Red9/hellenic-boards/documentation/gamma/gamma_gerber/gamma_stencil_thickness.png

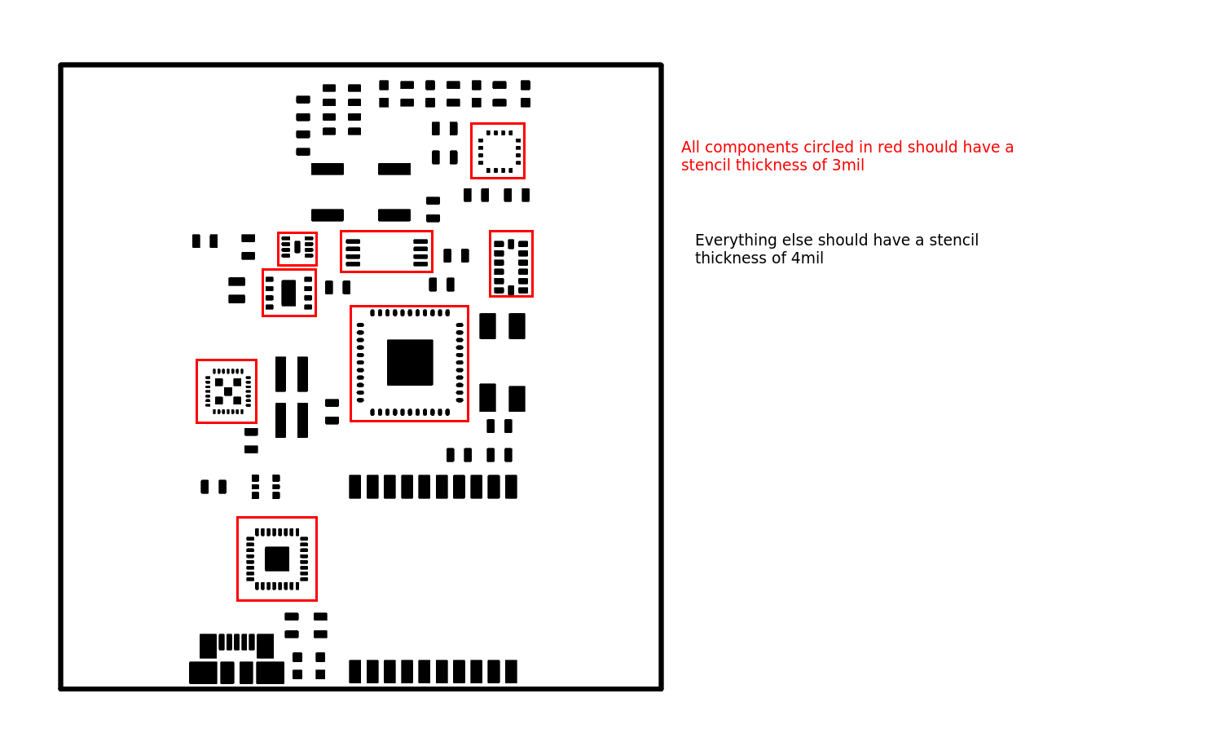
documentation/gamma/gamma_gerber/gamma_stencil_thickness.png
