Red9/hellenic-boards/documentation/gamma/scad.pdf

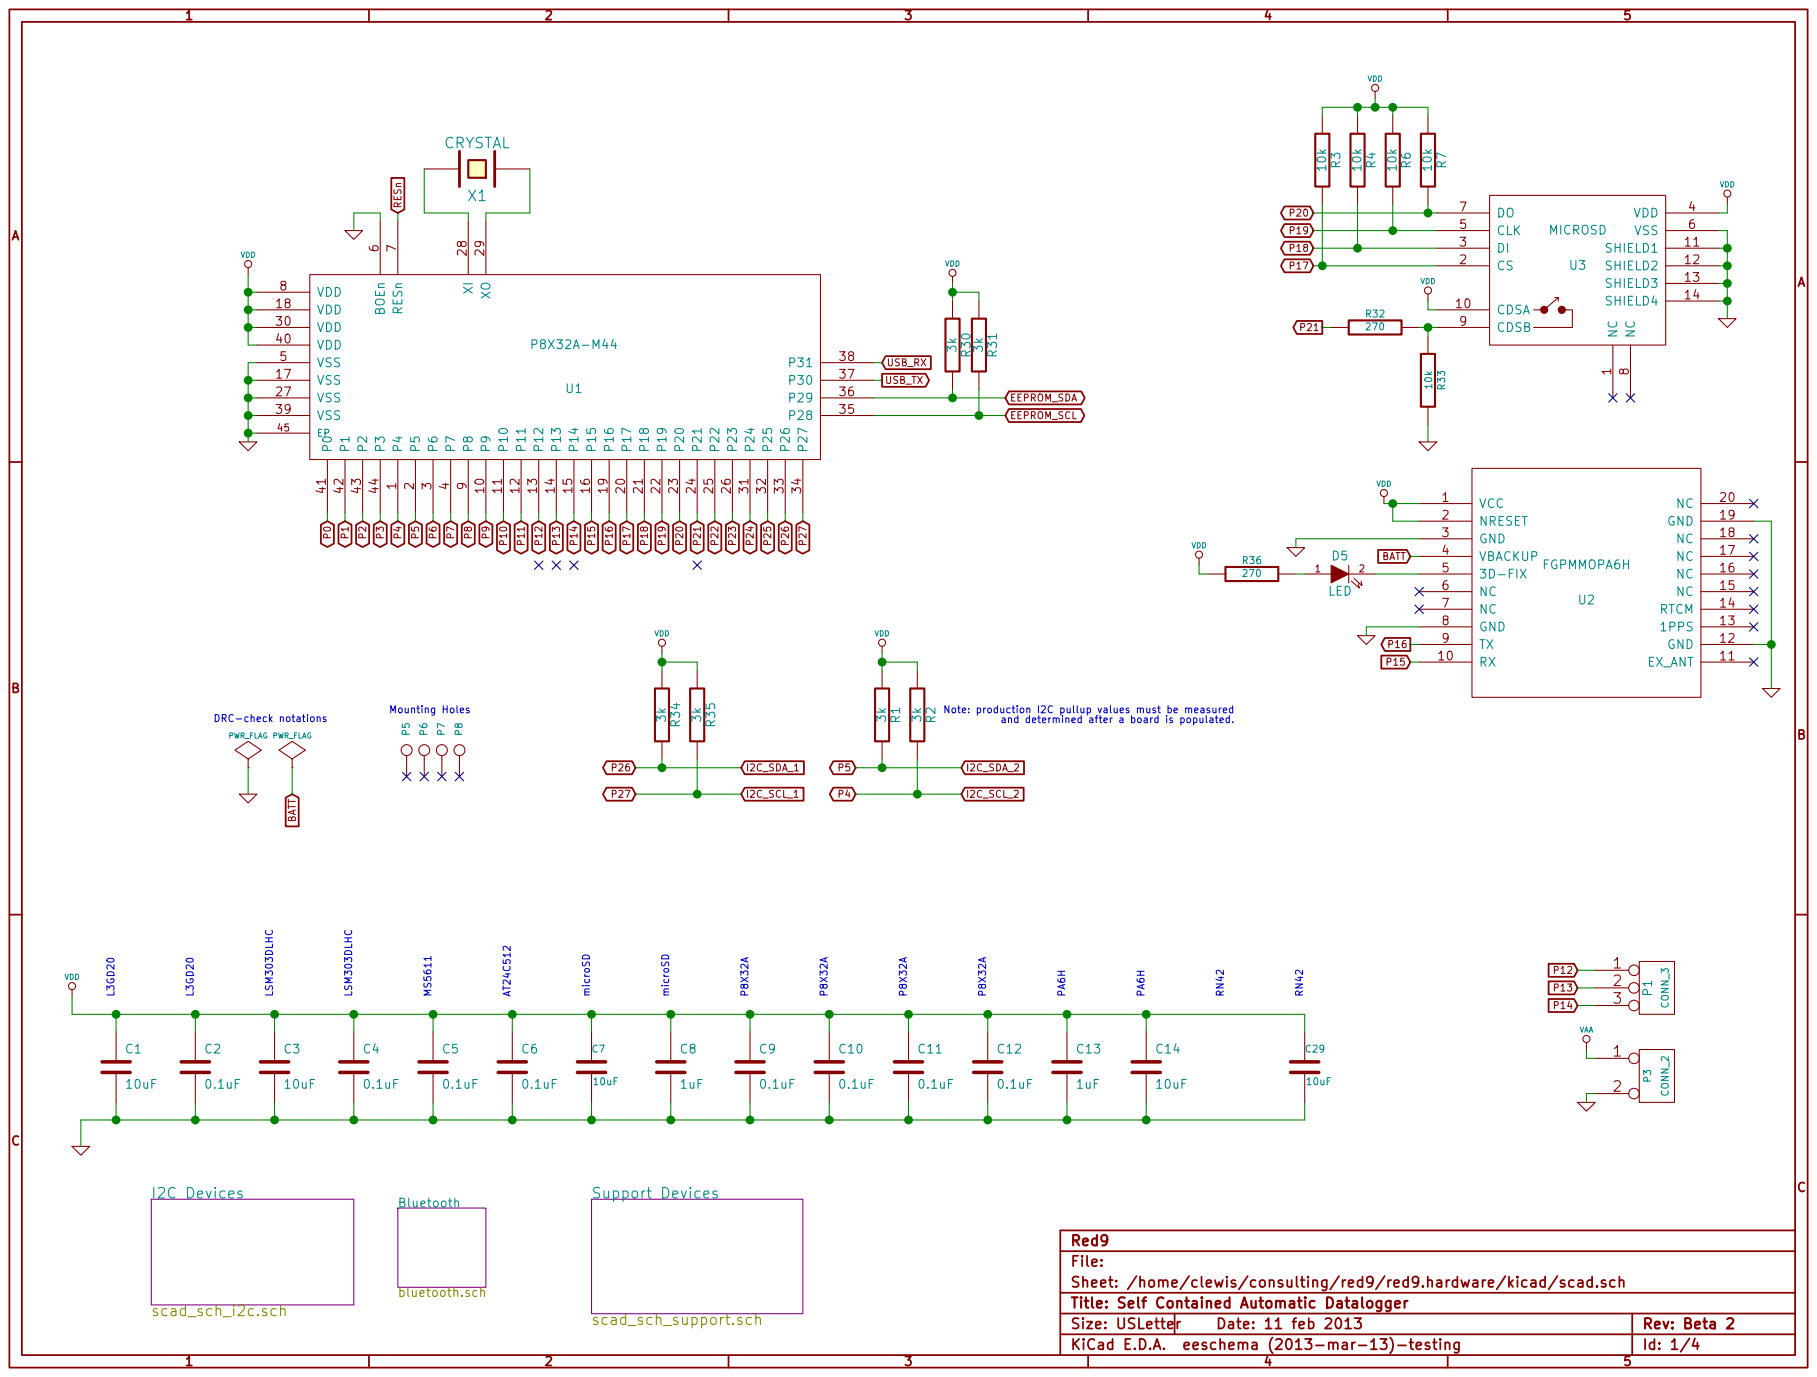
[picture p7: page 1]

1 CS 2 DI 3 VDD 4 CLK 5 VSS 6 DO 7 NC

Note: production I2C pullup values must be measured

C Red9 Sheet: /home/clewis/consulting/red9/red9.hardware/kicad/scad.sch File: Title: Self Contained Automatic Datalogger

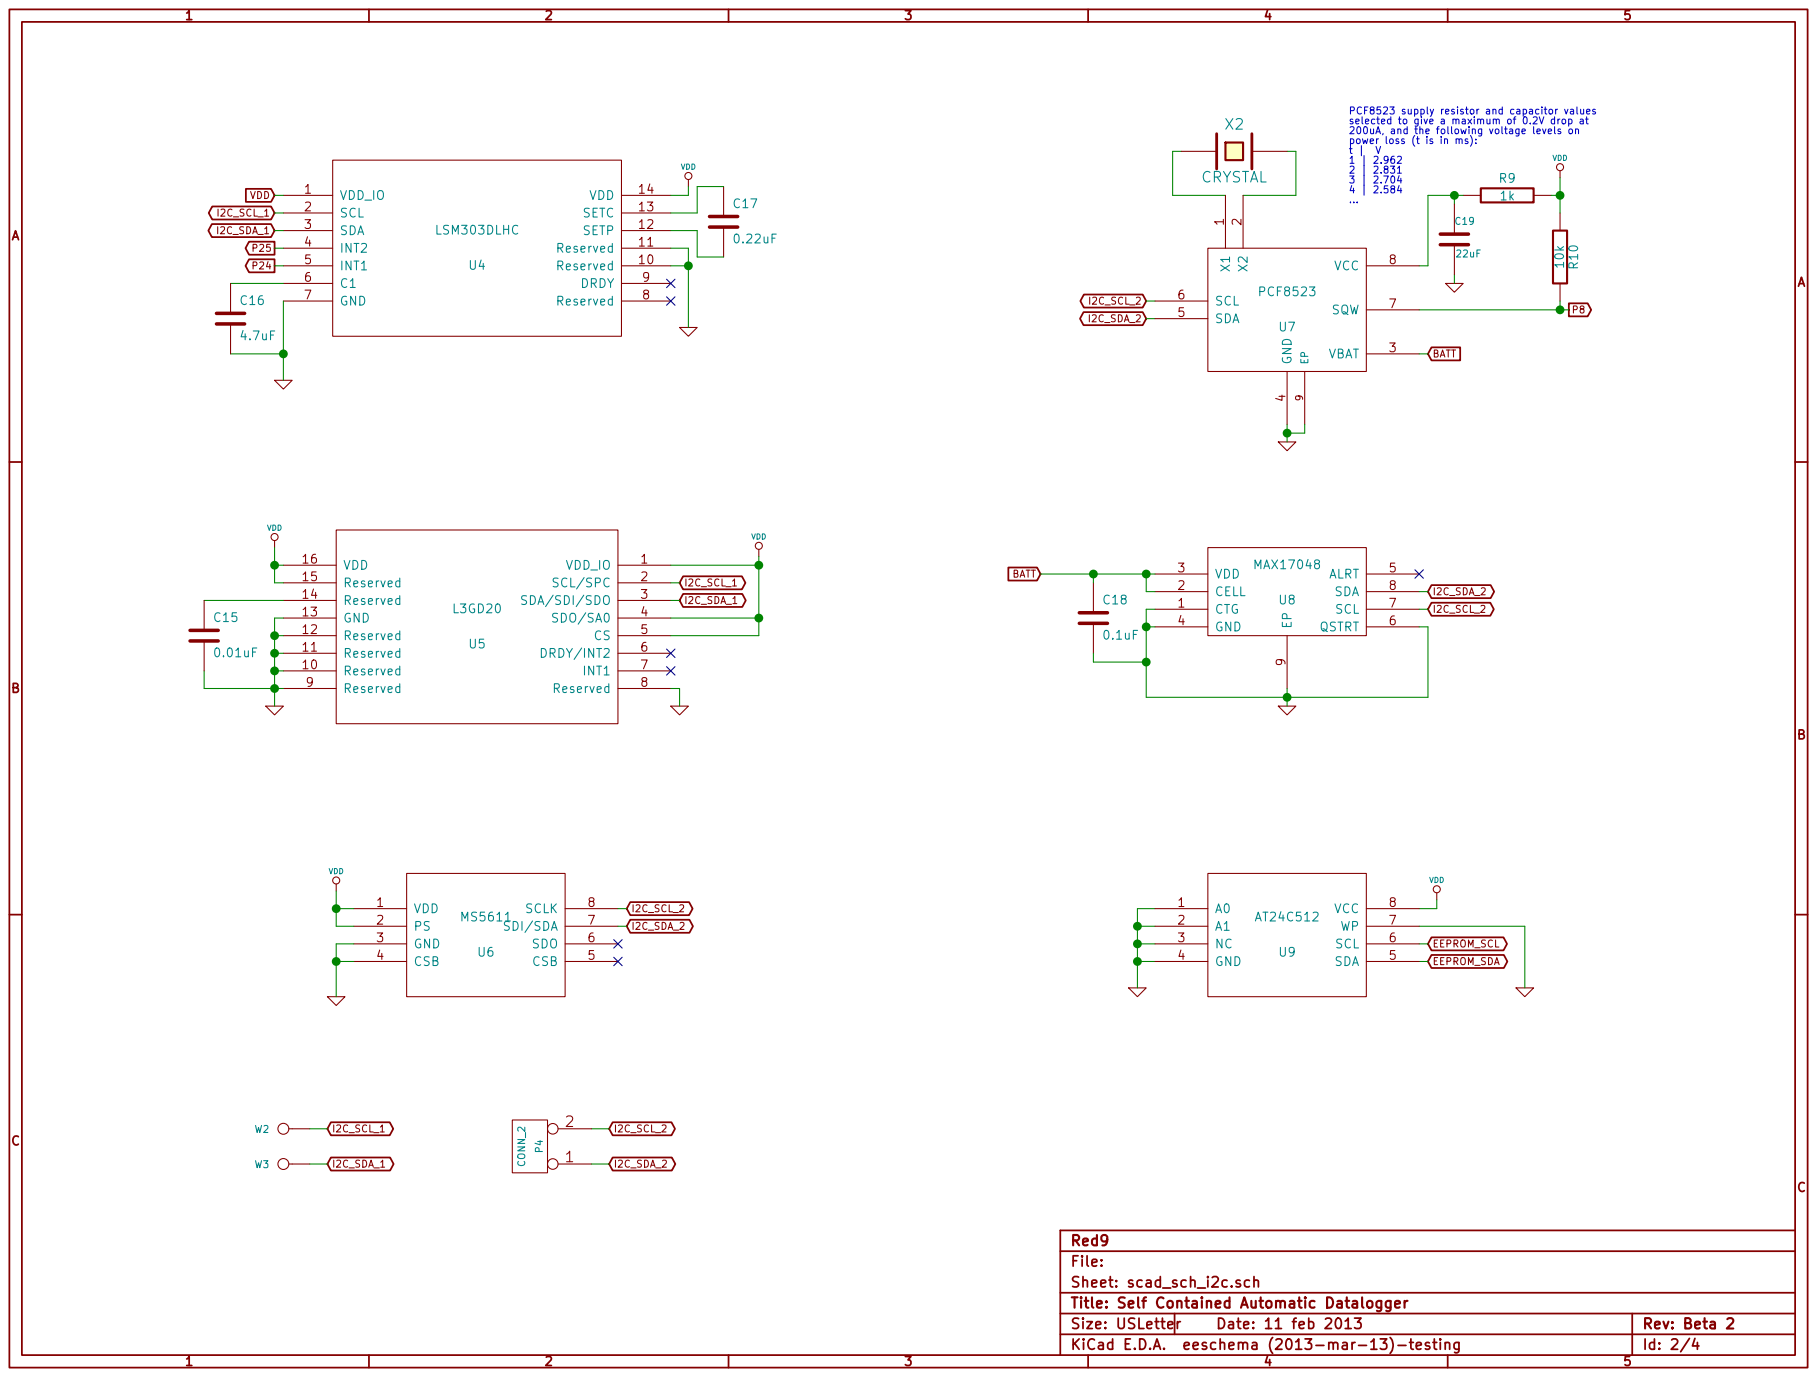
[picture p8: page 2]

1k PCF8523 supply resistor and capacitor values
selected to give a maximum of 0.2V drop at 200uA, and the following voltage levels on
power loss (t is in ms):

4 SDA 5 SCL 6 SQW 7 VCC 8 EP

C Red9 Sheet: scad_sch_i2c.sch File: Title: Self Contained Automatic Datalogger

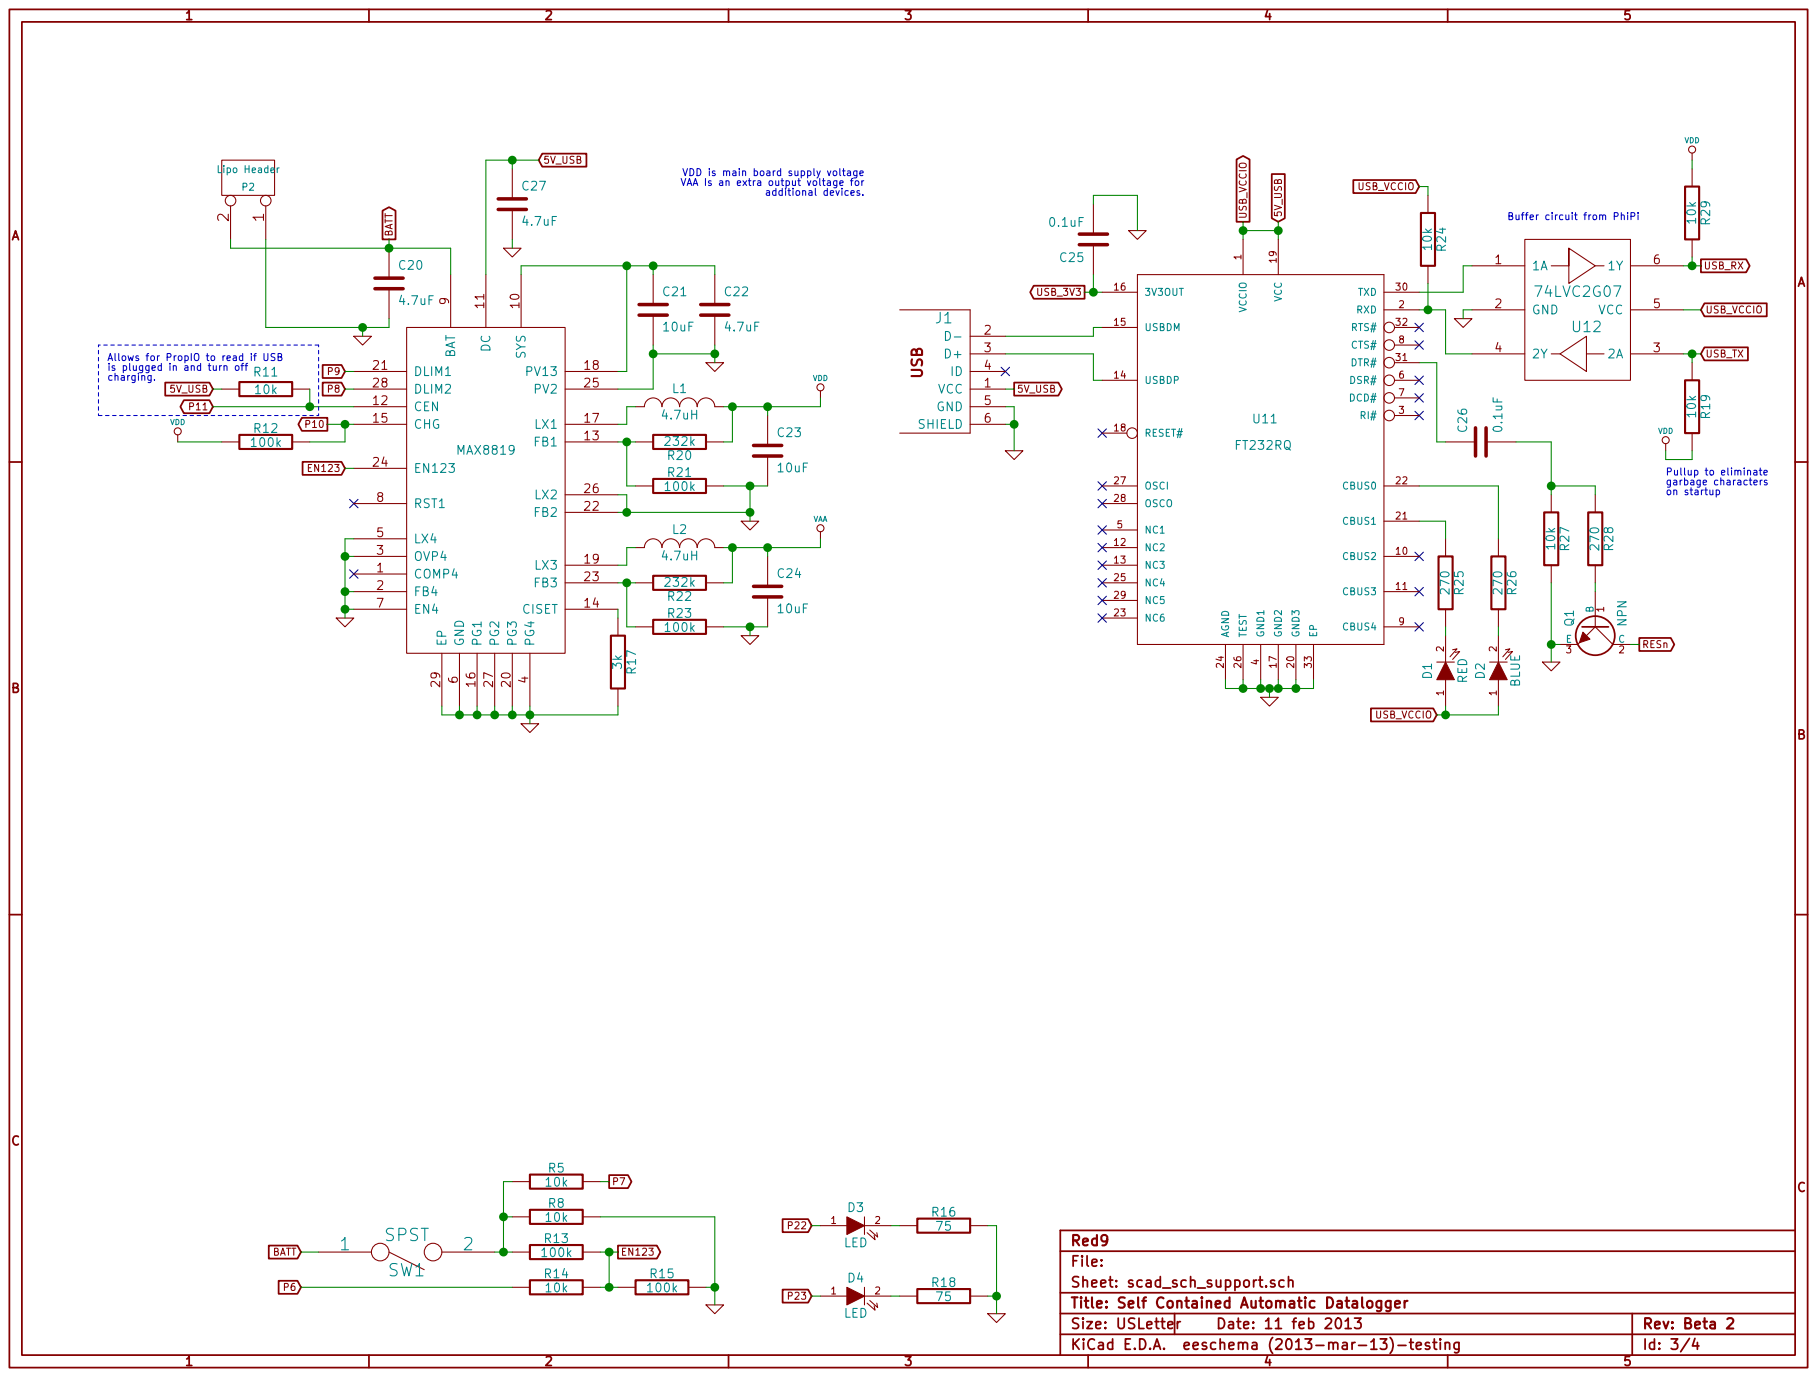
[picture p9: page 3]

VDD is main board supply voltage VAA Is an extra output voltage for

Buffer circuit from PhiPi

4 NC1 5 DSR# 6 DCD# 7 CTS# 8 CBUS4 9 CBUS2 10 GND3 20 TXD 30 CBUS3 11 CBUS1 21 DTR# 31 NC2 12 CBUS0 22 RTS# 32 NC3 13 NC6 23 EP 33 USBDP 14 AGND 24 USBDM 15 NC4 25

9 SYS 10 PG3 20 DC 11 DLIM1 21 CEN 12 FB2 22 FB1 13 FB3 23 CISET 14 EN123 24 CHG 15 PV2 25 PG1 16

VDD Allows for PropIO to read if USB

C Red9 Sheet: scad_sch_support.sch File: Title: Self Contained Automatic Datalogger

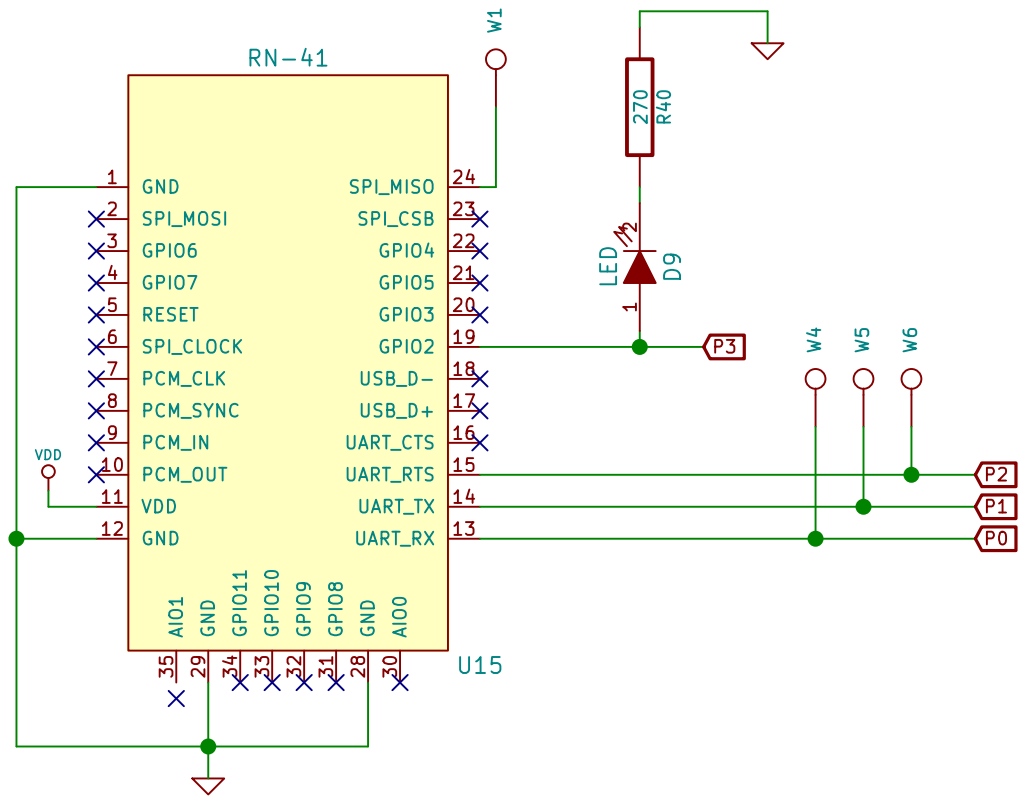
[picture p10: page 4]

C Sheet: bluetooth.sch File: Title:
