Red9/hellenic-boards/documentation/beta2/scad_beta2.pdf

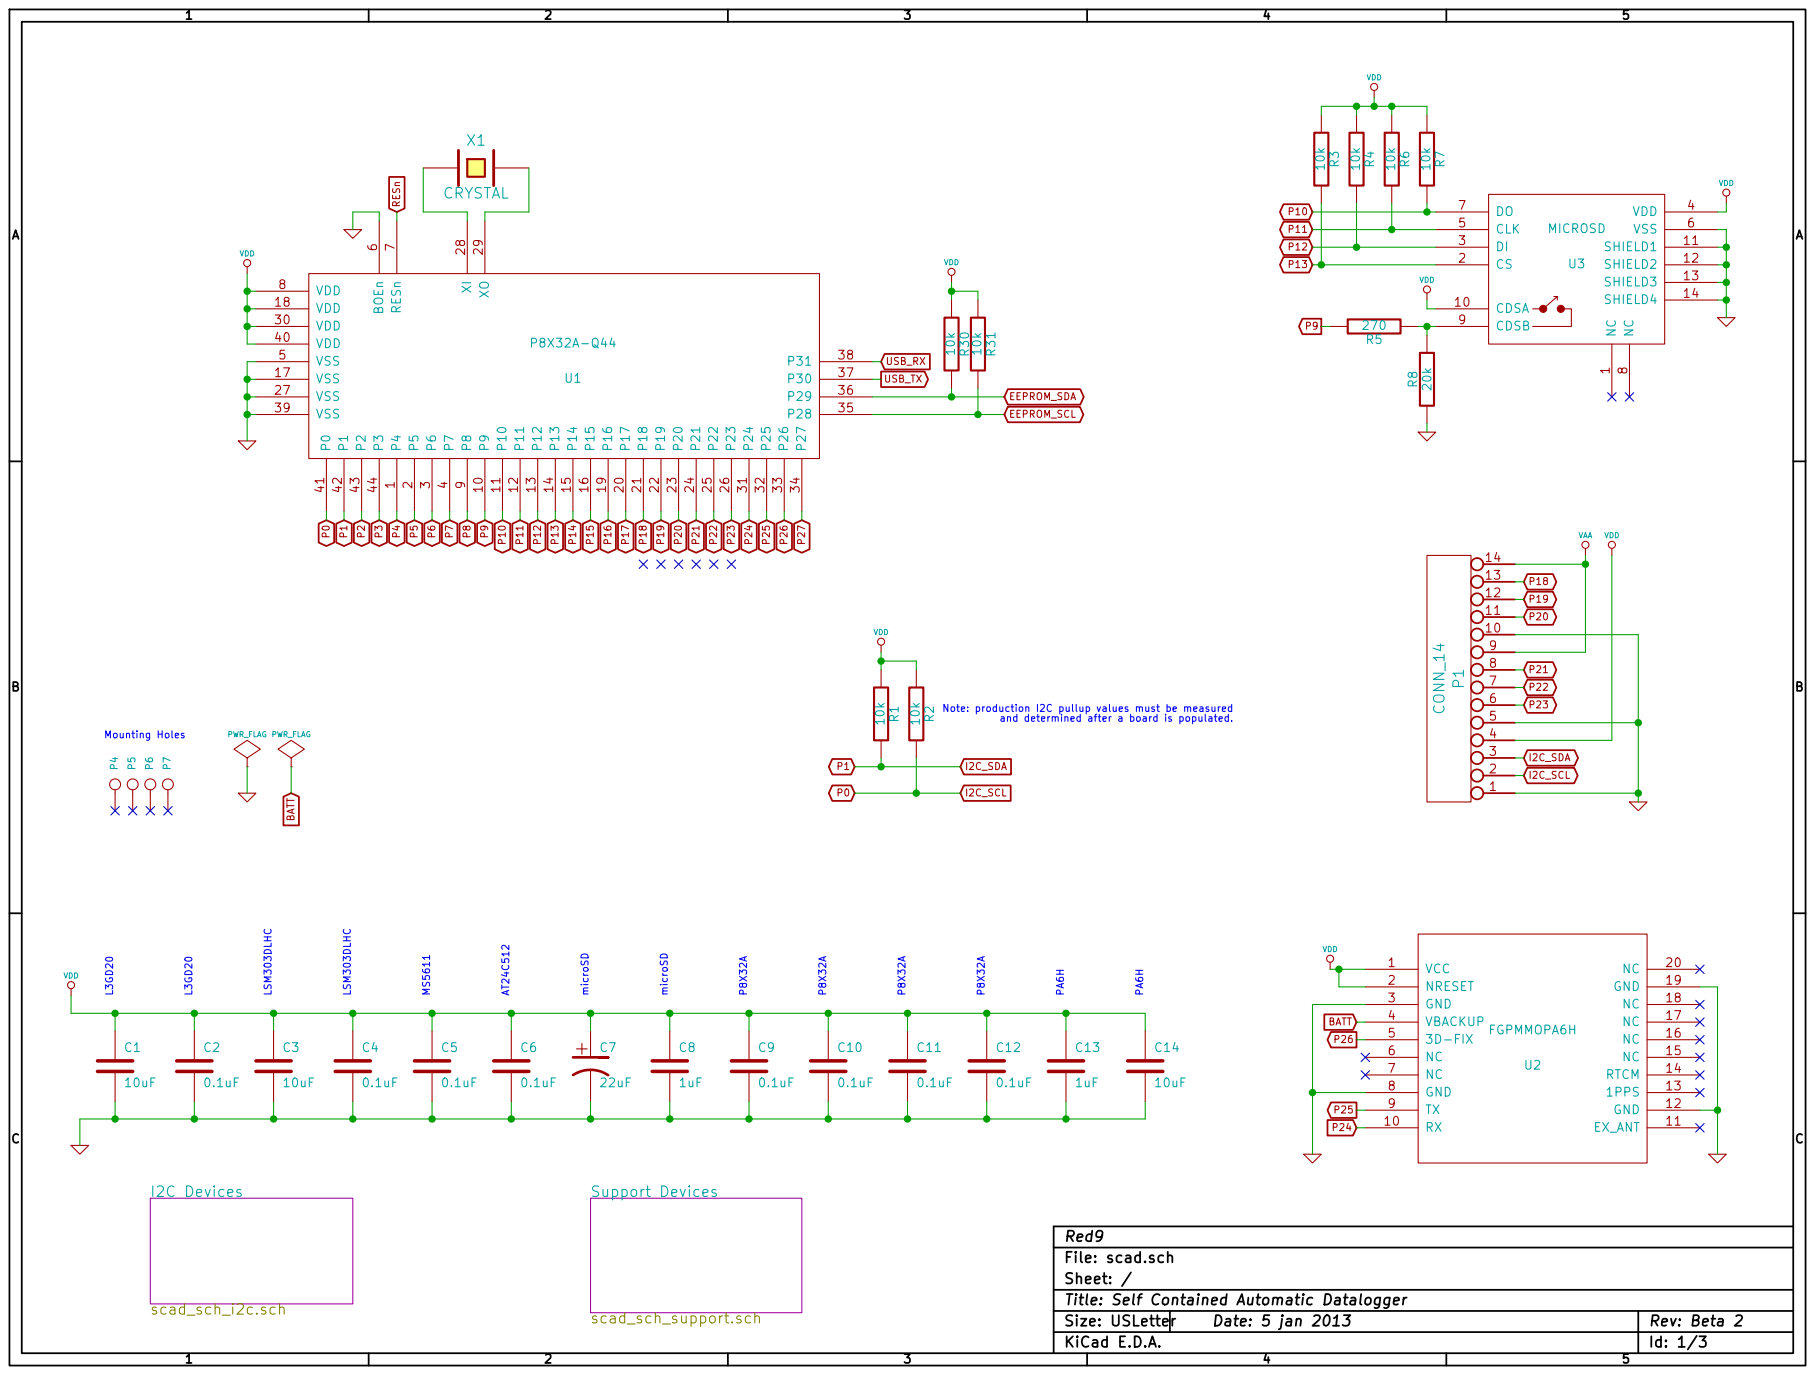
[picture p11: page 1]

1 CS 2 DI 3 VDD 4 CLK 5 VSS 6 DO 7 NC

9 P9 10 P17 20 VDD 30 VDD 40 P10 11 P18 21 P24 31 P0 41 P11 12 P19 22 P25 32 P1 42 P12 13 P20 23 P26 33 P2 43 P13 14 P21 24 P27 34 P3 44 P14 15 P22 25 P28 35 P15 16 P23 26 P29 36 VSS 17 VSS 27 P30 37 VDD 18 XI 28 P31 38 P16 19 XO 29 VSS 39 U1 P8X32A-Q44 NC

Title: Self Contained Automatic Datalogger File: scad.sch Sheet: / Red9 P4

Note: production I2C pullup values must be measured

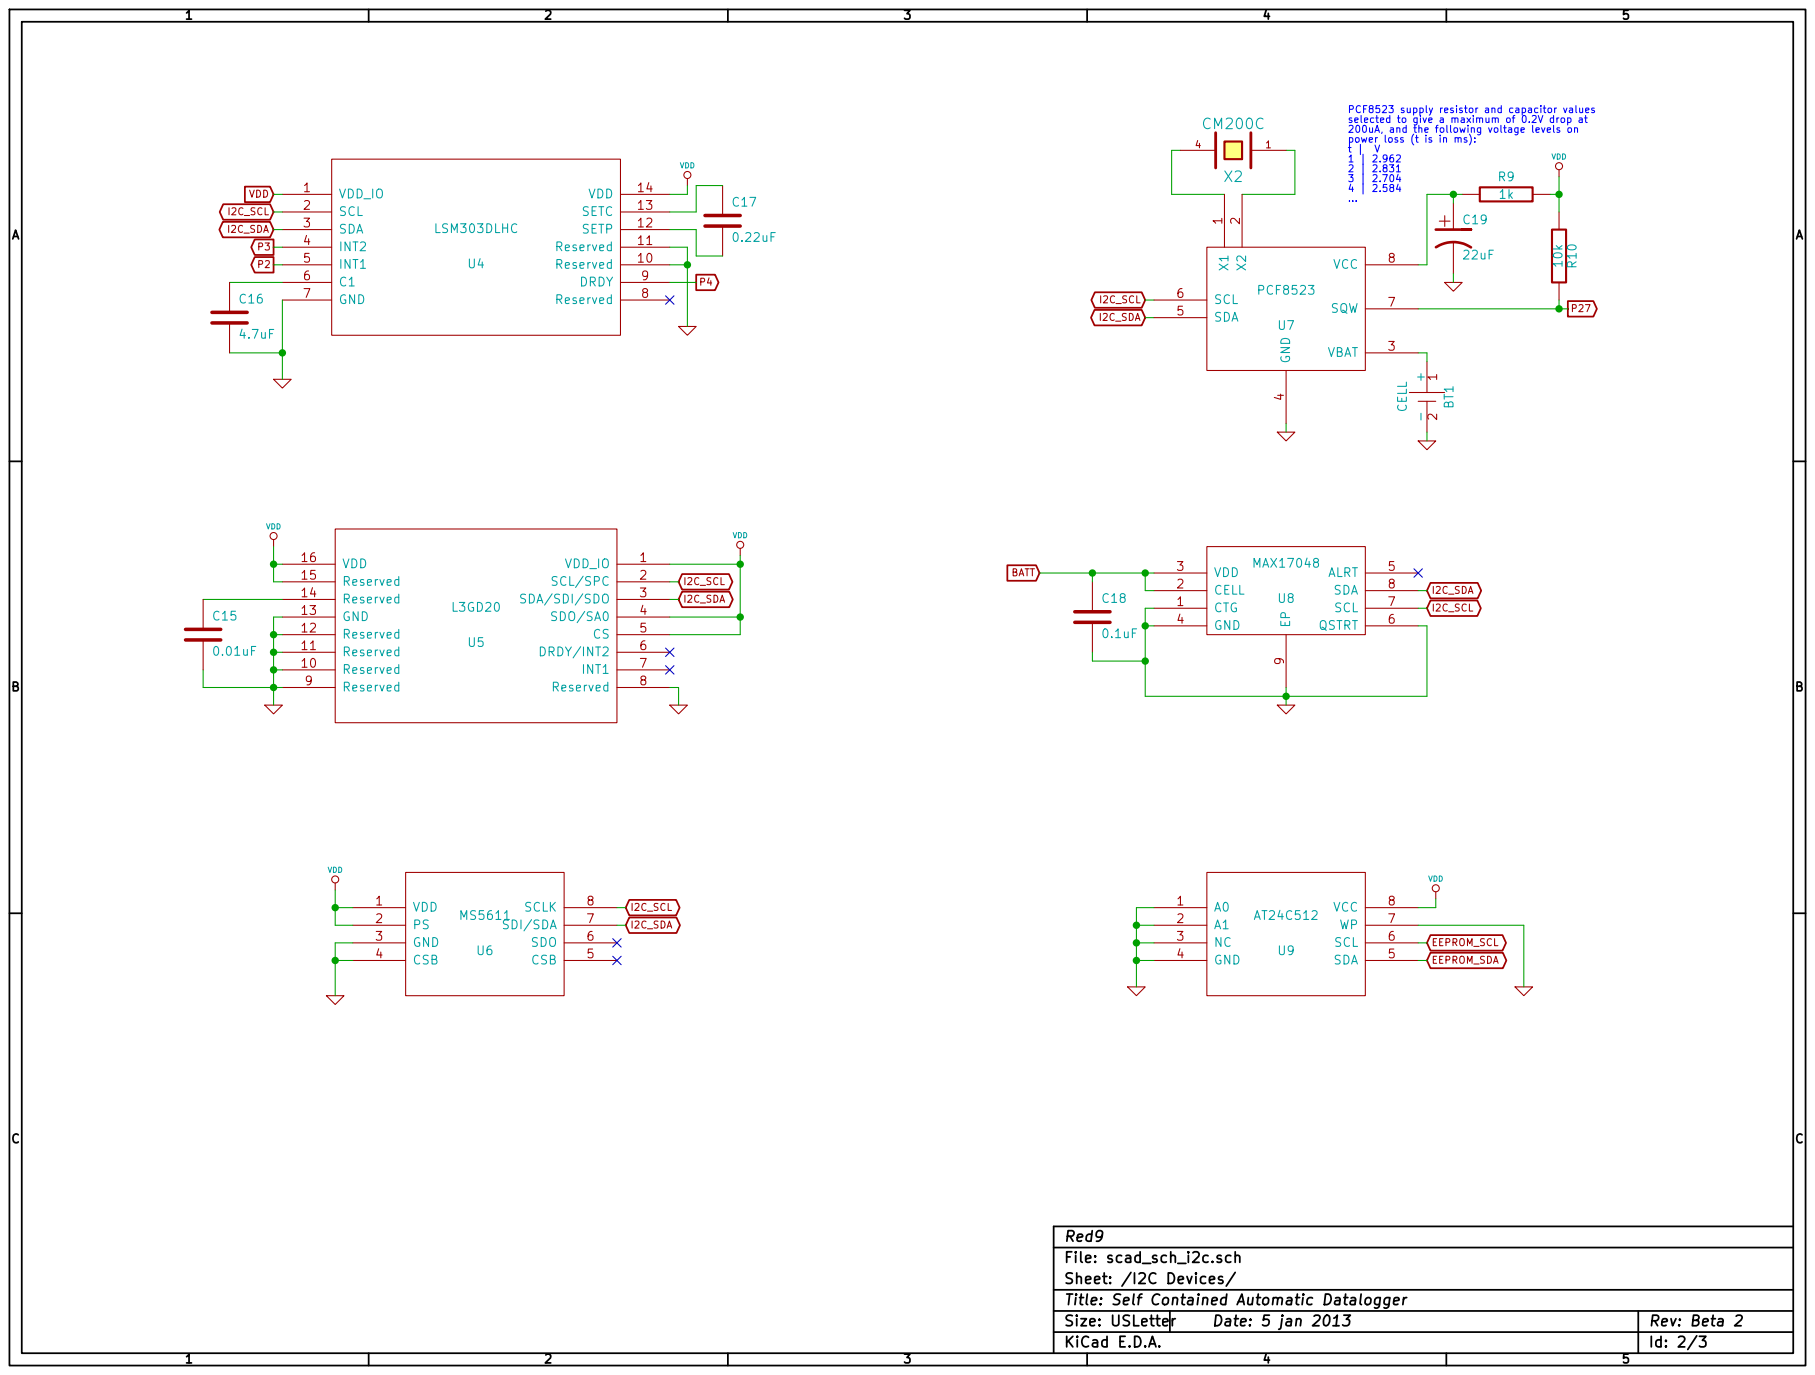
[picture p12: page 2]

1k PCF8523 supply resistor and capacitor values
selected to give a maximum of 0.2V drop at 200uA, and the following voltage levels on

4 SDA 5 SCL 6 SQW 7 VCC 8 U7 PCF8523

Title: Self Contained Automatic Datalogger

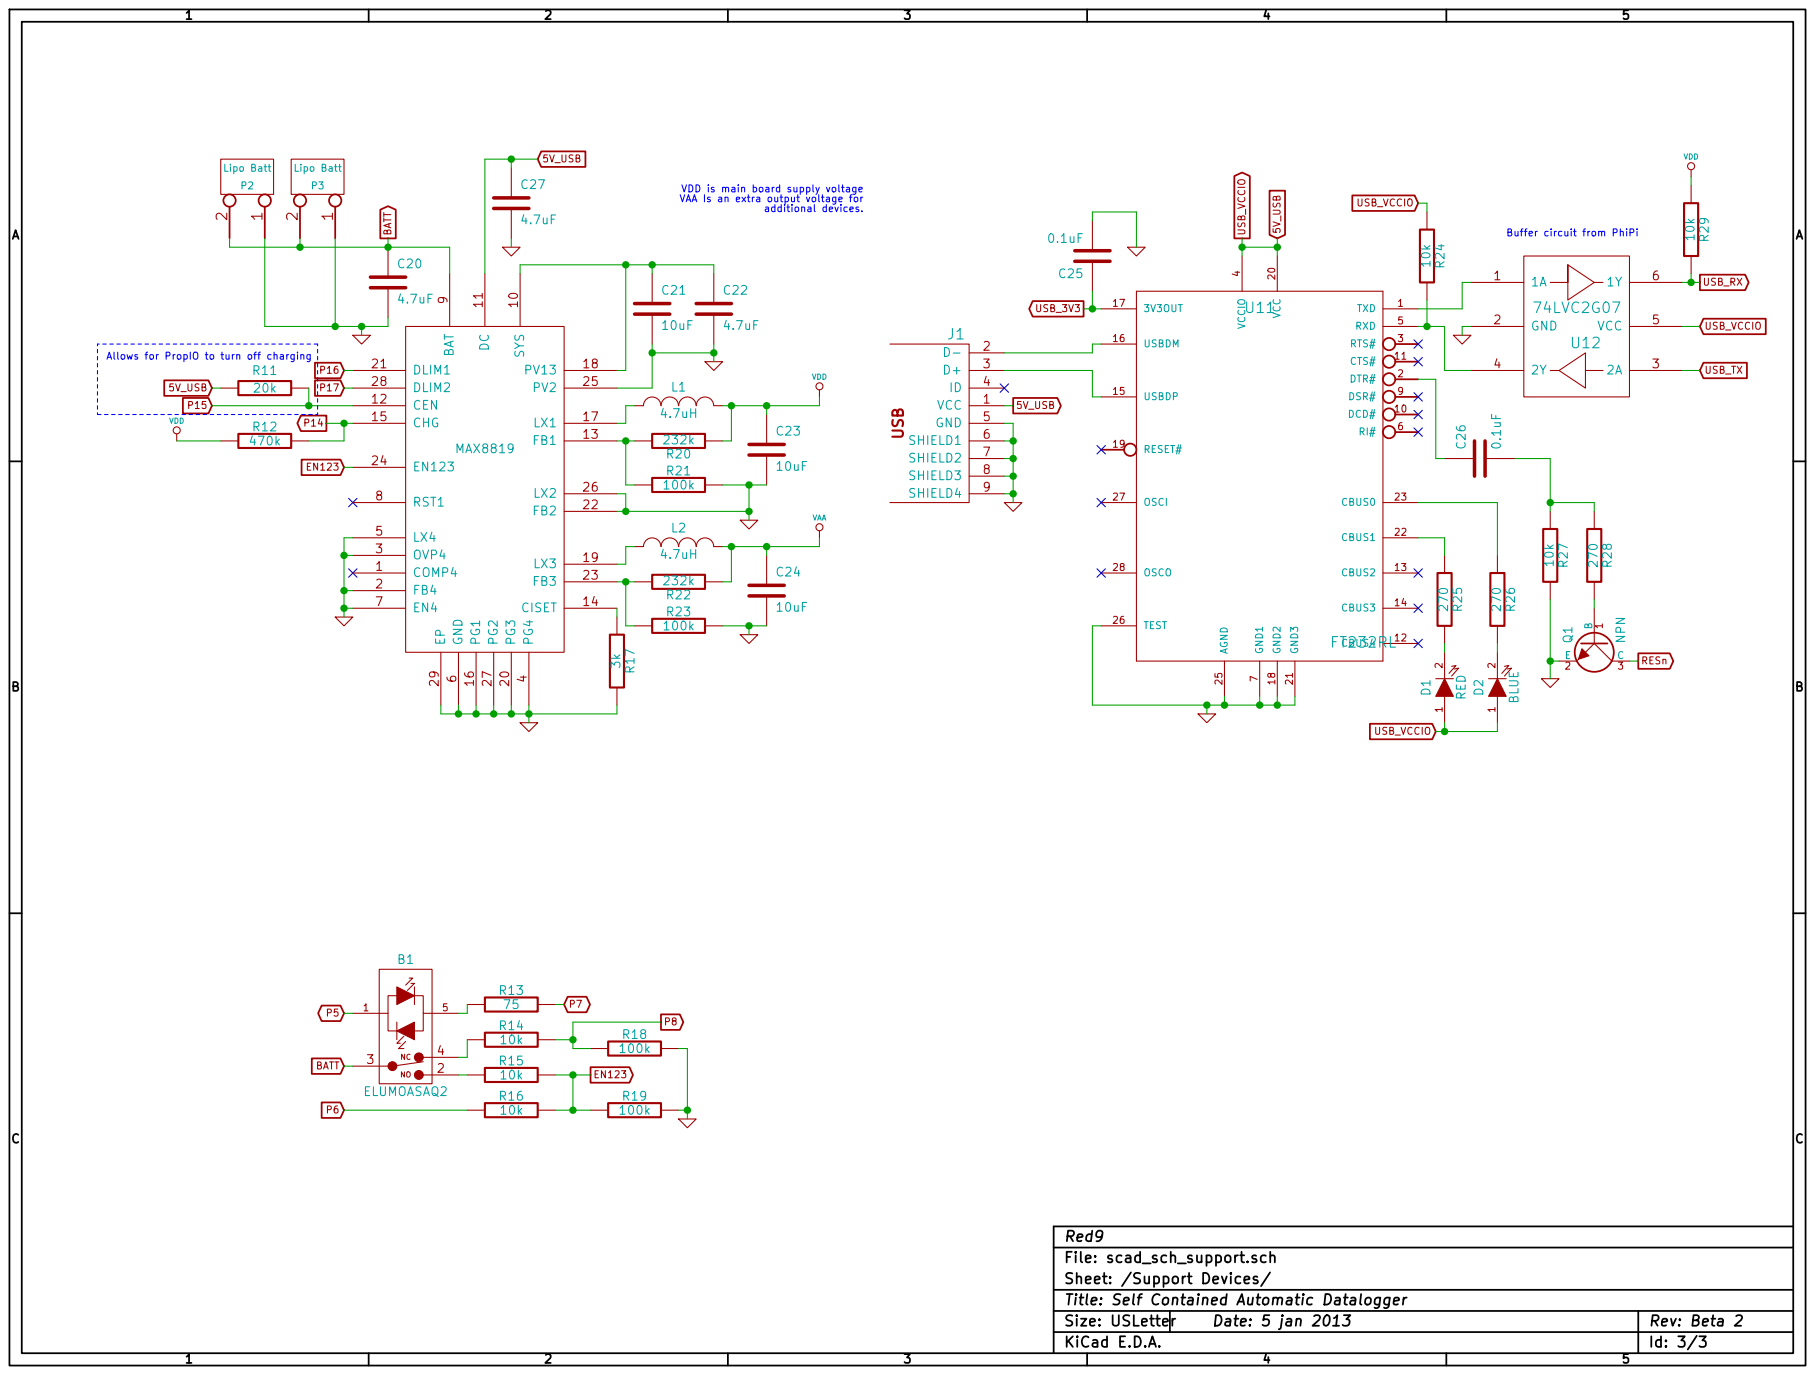
[picture p13: page 3]

USB_VCCIO
Buffer circuit from PhiPi B

VDD is main board supply voltage VAA Is an extra output voltage for

7 DSR# 9 DCD# 10 VCC 20 CTS# 11 GND3 21 CBUS4 12 CBUS1 22 CBUS2 13 CBUS0 23 CBUS3 14 USBDP 15 AGND 25 USBDM 16 TEST 26

9 SYS 10 PG3 20 DC 11 DLIM1 21 CEN 12 FB2 22 FB1 13 FB3 23 CISET 14 EN123 24 CHG 15 PV2 25 PG1 16

Title: Self Contained Automatic Datalogger
