Red9/hellenic-boards/documentation/beta2/SCAD-BETA-TOP.STENCIL.pdf

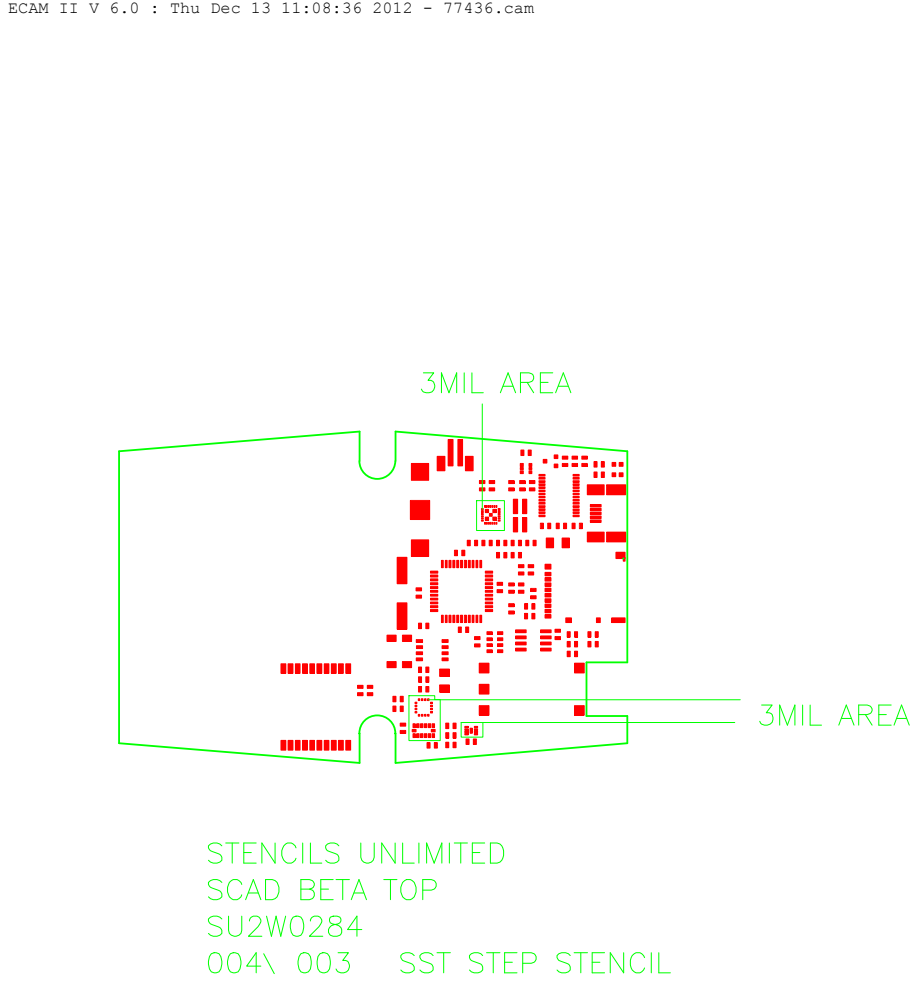
[picture p14: page 1]

ECAM II V 6.0 : Thu Dec 13 11:08:36 2012 - 77436.cam
