Red9/hellenic-boards/kicad/bluetooth.sch

## KiCad design kicad/bluetooth.sch (2013-07-19)

Schematic: bluetooth.sch

Parts:
D9: LED; LED-0603
R40: 270; SM0603
U15: RN-41
W1: CONN_1; 1PIN_S_SMD
W4, W5, W6: CONN_1
