Red9/hellenic-boards/kicad/scad.sch

## KiCad design kicad/scad.sch (2013-07-19)

Schematic: scad.sch

Parts:
C1, C3, C7, C14, C29: 10uF; SM0603_Capa
C2, C4, C5, C6, C9, C10, C11, C12: 0.1uF; SM0603_Capa
C8, C13: 1uF; SM0603_Capa
D5: LED; LED-0603
P1: CONN_3
P3: CONN_2
P5, P6, P7, P8: CONN_1
R1, R2, R30, R31, R34, R35: 3k; SM0603
R3, R4, R6, R7, R33: 10k; SM0603
R32, R36: 270; SM0603
U1: P8X32A-M44
U2: FGPMMOPA6H
U3: MICROSD; DM3AT-SF-PEJM5
X1: CRYSTAL; ECX-53B

Notes on the sheet:
L3GD20
LSM303DLHC
MS5611
AT24C512
microSD
P8X32A
PA6H
Note: production I2C pullup values must be measured and determined after a board is populated.
DRC-check notations
RN42
Mounting Holes
