Red9/hellenic-boards/kicad/scad_sch_i2c.sch

## KiCad design kicad/scad_sch_i2c.sch (2013-07-19)

Schematic: scad_sch_i2c.sch

Parts:
C15: 0.01uF; SM0603_Capa
C16: 4.7uF; SM0603_Capa
C17: 0.22uF; SM0603_Capa
C18: 0.1uF; SM0603_Capa
C19: 22uF; SM0603_Capa
P4: CONN_2
R9: 1k; SM0603
R10: 10k; SM0603
U4: LSM303DLHC; LGA-14
U5: L3GD20; LGA-16
U6: MS5611
U7: PCF8523; SOT909-EP
U8: MAX17048; TDFN-EP8
U9: AT24C512; -TSSOP8
W2, W3: CONN_1
X2: CRYSTAL; ST2012SB

Notes on the sheet:
PCF8523 supply resistor and capacitor values selected to give a maximum of 0.2V drop at 200uA, and the following voltage levels on power loss (t is in ms): t | V 1 | 2.962 2 | 2.831 3 | 2.704 4 | 2.584 ...
