Red9/hellenic-boards/kicad/scad_sch_support.sch

## KiCad design kicad/scad_sch_support.sch (2013-07-19)

Schematic: scad_sch_support.sch

Parts:
C20, C22, C27: 4.7uF; SM0603_Capa
C21, C23, C24: 10uF; SM0603_Capa
C25, C26: 0.1uF; SM0603_Capa
D1: RED; LED-0603
D2: BLUE; LED-0603
D3, D4: LED; LED-0603
J1: USB_MICRO_B_SMD; MOLEX_47346_0001
L1, L2: 4.7uH; NR3012
P2: Lipo Header; BatteryHeader
Q1: NPN; SOT-23
R5, R8, R11, R14, R19, R24, R27, R29: 10k; SM0603
R12, R13, R15, R21, R23: 100k; SM0603
R16, R18: 75; SM0603
R17: 3k; SM0603
R20, R22: 232k; SM0603
R25, R26, R28: 270; SM0603
SW1: SPST; KSC9-J
U10: MAX8819; TQFN-EP28
U11: FT232RQ
U12: 74LVC2G07; SOT363-6

Notes on the sheet:
Allows for PropIO to read if USB is plugged in and turn off charging.
VDD is main board supply voltage VAA Is an extra output voltage for additional devices.
Pullup to eliminate garbage characters on startup
Buffer circuit from PhiPi
