Red9/hellenic-boards/(commit log)

2013-01-09 Beta 2 Revision.
    [scad.brd, scad.sch, scad_rev_alpha.csv, scad_rev_beta.csv, scad_sch_i2c.sch, scad_sch_support.sch]
2013-01-22 Updated schematic component values to reduce unique component count.
    [scad.csv, scad.sch, scad_sch_i2c.sch, scad_sch_support.sch]
2013-01-31 Built boards 14 through 24, updated their status.
    [BuildStatusMasterList.ods]
2013-01-31 Changed to better print settings.
    [BuildStatusMasterList.ods]
2013-02-11 Nearly final version. Added 3D models, improved routing of Gamma.
    [BuildStatusMasterList.ods, scad.brd, scad.sch, scad_sch_i2c.sch, scad_sch_support.sch]
2013-02-11 Gamma: Ready to cleanly route board. Added 3D components.
    [scad.brd, scad.sch, scad_sch_i2c.sch, scad_sch_support.sch]
2013-07-08 Without the beta2 pictures; began addition of RN42 bluetooth module and layout of components.
    [BuildStatusMasterList.ods, UnitStatusMasterList.ods, bluetooth.sch, scad.brd, scad.sch, scad_sch_i2c.sch, scad_sch_support.sch]
2013-07-10 Placed all componets, and it can (almost) autoroute now. About ready to back import the traces.
    [bluetooth.sch, scad.brd, scad.sch, scad_sch_i2c.sch, scad_sch_support.sch]
2013-07-10 First attempt at FreeDFM approval. It passed, and everything seems to be good.
    [scad.brd]
2013-07-16 Finished laying everything out. All parts, silkscreens, etc. are done. Importing traces now.
    [UnitStatusMasterList.ods, bluetooth.sch, scad.brd, scad.sch, scad_sch_i2c.sch, scad_sch_support.sch]
2013-07-16 Back imported traces. Added fills and a few vias to ground.
    [scad.brd]
2013-07-16 Changed via size on board. Ready to back import traces.
    [scad.brd]
2013-07-17 Final routing done. All checks pass. Still need to update solder paste layer for components with EP.
    [scad.brd]
2013-07-17 Updated solder paste layers for exposed pad.
    [scad.brd]
2013-07-19 Finalized Gamma design that has been sent for manufacturing.
    [Gamma_BOM.csv, UnitStatusMasterList.ods, bluetooth.sch, scad.brd, scad.sch, scadParts.csv, scad_sch_i2c.sch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]
2015-06-23 Added some missing documentation and files.
    [scad-B_Cu.gbl, scad-B_Mask.gbs, scad-B_Paste.gbp, scad-B_SilkS.gbo, scad-Cmts_User.gbr, scad-F_Cu.gtl, scad-F_Mask.gts, scad-F_Paste.gtp]
